OlexOlex/TPE-Module_v3/data/publicslavepic.jpg

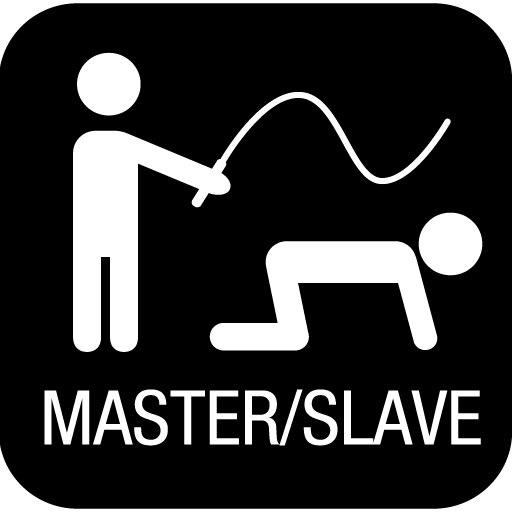
data/publicslavepic.jpg
