OlexOlex/TPE-Module_v3/HW/Wiring_TPEM_v3.pdf

## TPE-Module v3 wiring © Olex 2020

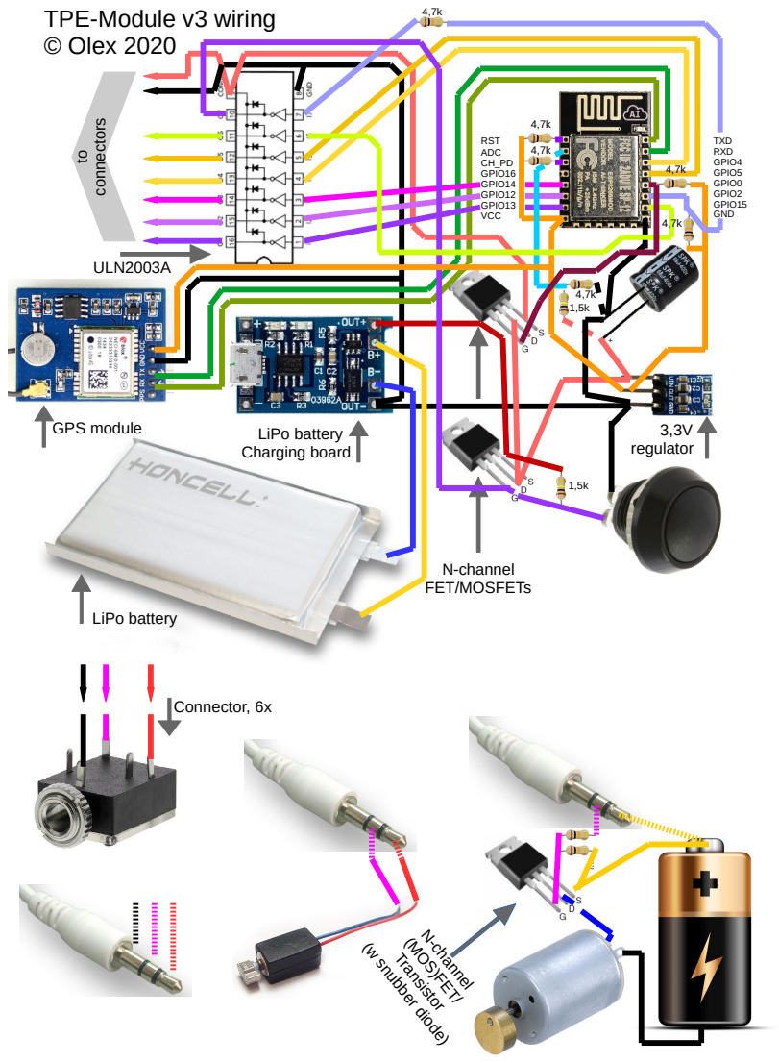
[picture p2: page 1]
TXD RXD GPIO4 GPIO5 GPIO0 GPIO2 GPIO15 GND; RST ADC CH_PD GPIO16 GPIO14 GPIO12 GPIO13 VCC; N-channel FET/MOSFETs; N-channel (MOS)FET/ Transistor; (w snubber diode); GPS module; LiPo battery; 3,3V regulator; LiPo battery Charging board; ULN2003A; Connector, 6x; ctors
