OlexOlex/TPE-Module_v3/(commit log)

2019-12-09 fixed error in comment
    [TPEMv3.ino]
2020-09-26 Release files added, wiring schema fixed and mproved
